kimtonyhyun/active_avoidance/README.md

## Assembly instructions

View instructions on [Github.io](https://kimtonyhyun.github.io/active_avoidance/)

Use the navigation bar on the left to proceed.
