kimtonyhyun/active_avoidance/docs/top_side.md

---
layout: default
title: 4. Top side of apparatus
nav_order: 5
---

# 4. Top side of the apparatus
{: .no_toc }

## Table of contents
{: .no_toc .text-delta }

1. TOC
{:toc}

---

## Place the wheel

Mount the wheel and encoder on the top side of the apparatus using standard optomechanical hardware:
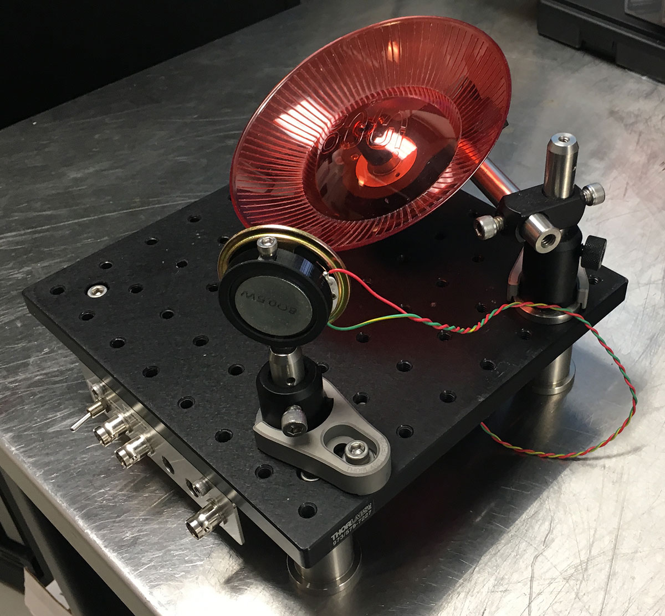
[picture p25: docs/mounted_wheel.jpg]
Mount the wheel and encoder on the top side of the apparatus
