kimtonyhyun/active_avoidance/stl/holder_usdigital_base.stl

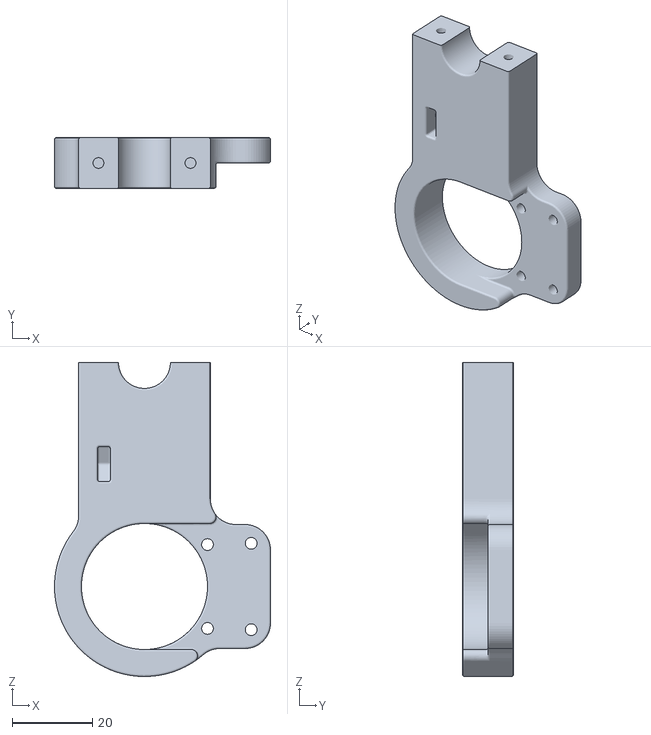
[picture p33: CAD file, 2019-06-15]
stl/holder_usdigital_base.stl
54.0 x 12.7 x 78.5
