kimtonyhyun/active_avoidance/stl/holder_usdigital_cap.stl

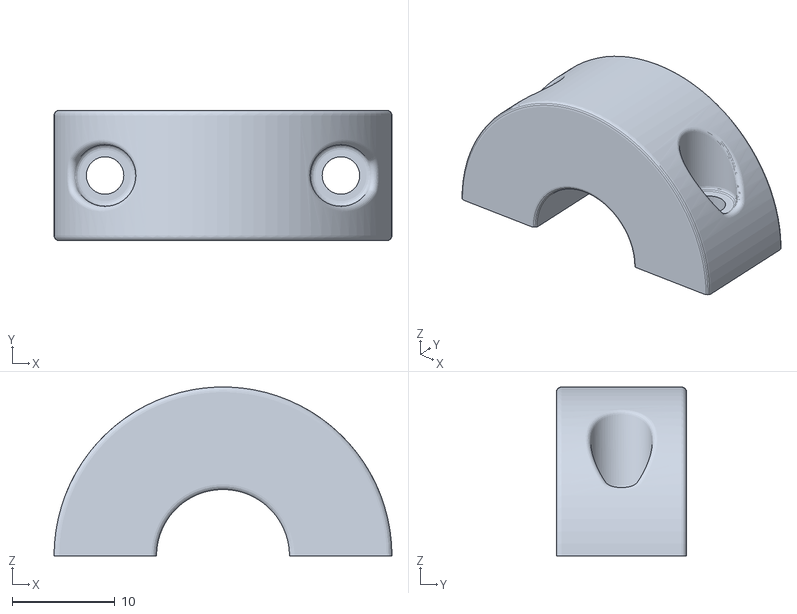
[picture p34: CAD file, 2019-06-15]
stl/holder_usdigital_cap.stl
33.0 x 12.7 x 16.5
