kimtonyhyun/active_avoidance/stl/wavtrig_mount_rev2.stl

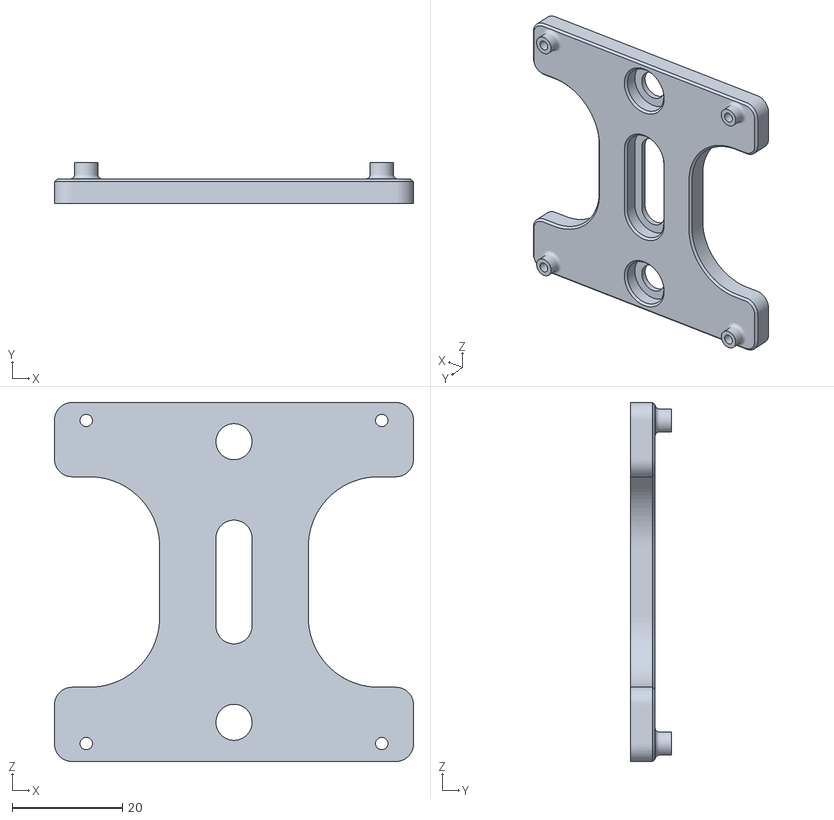
[picture p35: CAD file, 2019-06-15]
stl/wavtrig_mount_rev2.stl
65.0 x 7.50 x 65.0
