kimtonyhyun/active_avoidance/stl/speaker_mount.stl

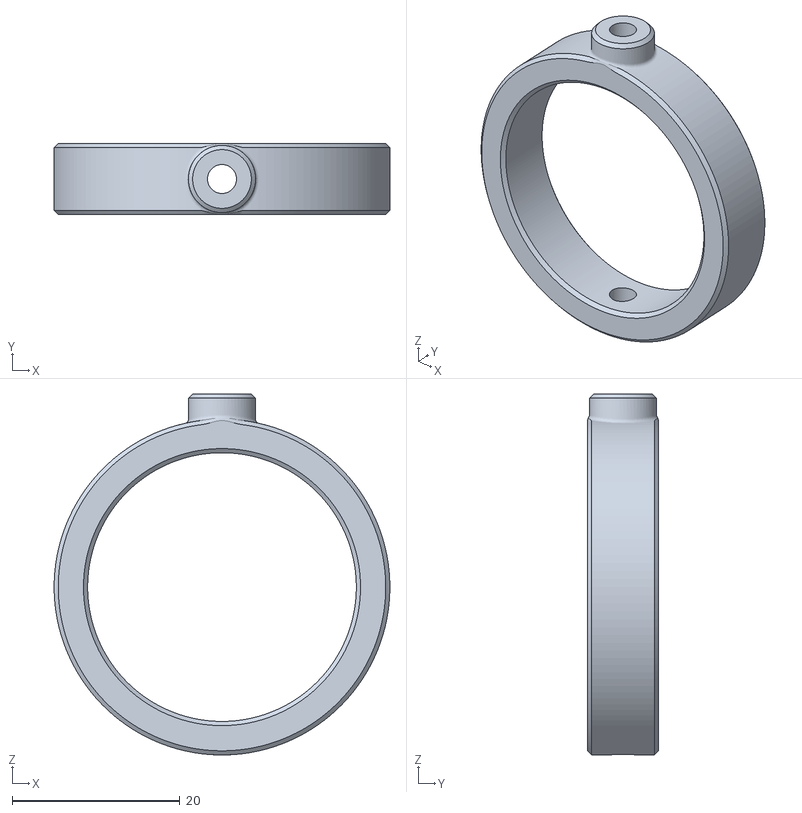
[picture p36: CAD file, 2019-06-15]
stl/speaker_mount.stl
40.0 x 8.50 x 43.0
