kimtonyhyun/active_avoidance/stl/arduino_mega_mount.stl

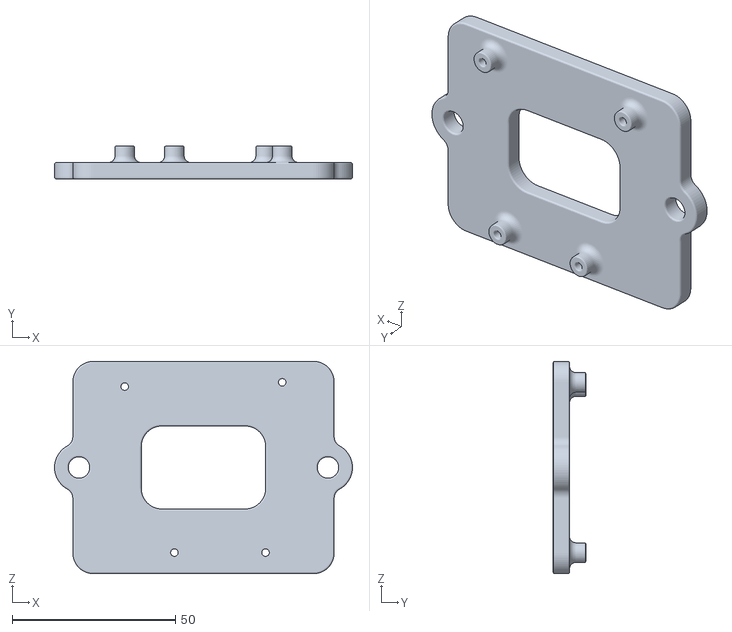
[picture p37: CAD file, 2019-06-15]
stl/arduino_mega_mount.stl
91.2 x 10.0 x 65.0
