kimtonyhyun/active_avoidance/stl/wheel_adapter.stl

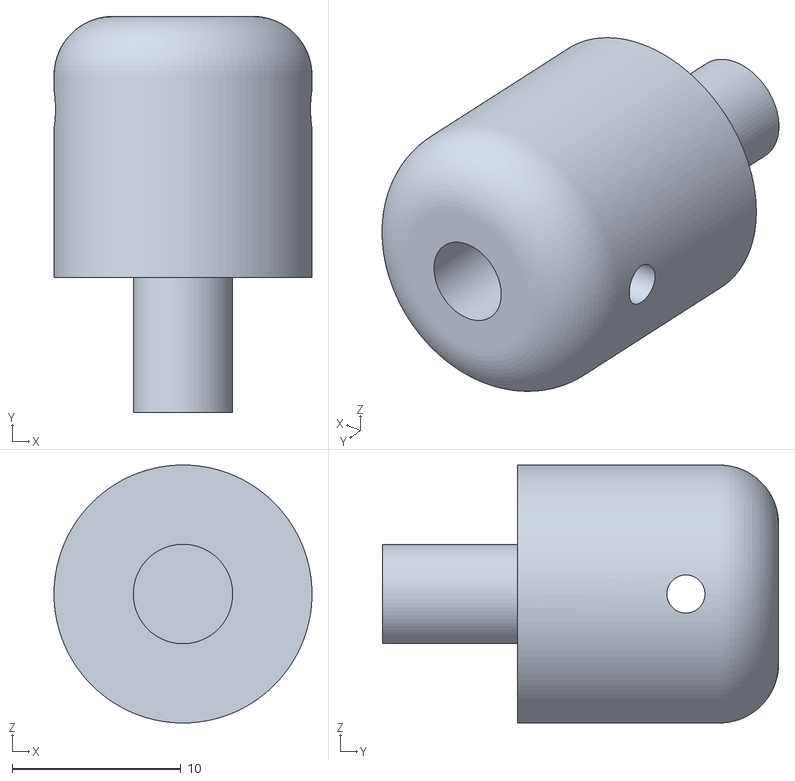
[picture p38: CAD file, 2019-06-15]
stl/wheel_adapter.stl
15.3 x 23.5 x 15.3
