kimtonyhyun/active_avoidance/stl/aa_panel_adapter.stl

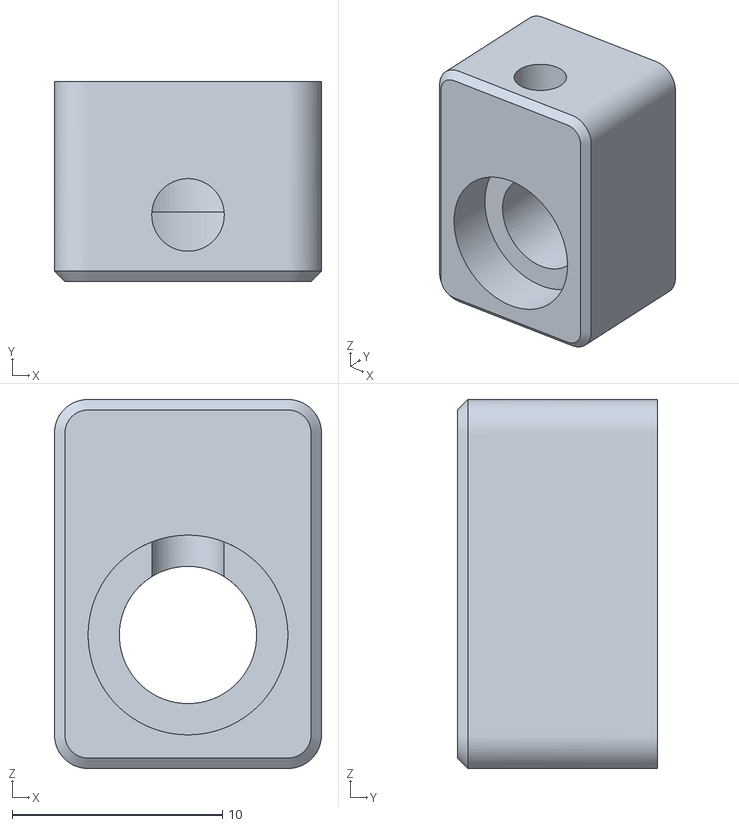
[picture p39: CAD file, 2019-06-15]
stl/aa_panel_adapter.stl
12.7 x 9.52 x 17.5
