kimtonyhyun/active_avoidance/(commit log)

2019-06-08 Solder jumper
2019-06-09 Encoder mount
2019-06-09 Wheel pictures
2019-06-14 Populating circuits
2019-06-14 BNC panel wiring
2019-06-14 WAV Trigger wiring photos
2019-06-14 Encoder pictures
2019-06-15 3D printed parts
    [aa_panel_adapter.stl]
2019-06-15 More 3D printed files
    [arduino_mega_mount.stl, speaker_mount.stl, wavtrig_mount_rev2.stl, wheel_adapter.stl]
2019-06-15 Encoder mounts
    [holder_usdigital_base.stl, holder_usdigital_cap.stl]
2019-06-15 Frame clock
2019-06-15 Saleae grounding
2019-06-15 Mounted wheel
2019-06-15 Arduino screenshot
